s-hfarooq/IV18-Clock/pcb/v1/BOM_IV18-Clock_2023-02-18.csv

ID | Name | Designator | Footprint | Quantity | Manufacturer Part | Manufacturer | Supplier | Supplier Part | Price | Pins
1 | 19-213/Y2C-CQ2R2L/3T(CY) | 3V3,RXD1,TXD1 | LED0603-R-RD | 3 | 19-213/Y2C-CQ2R2L/3T(CY) | EVERLIGHT | LCSC | C72038 | 0.004 | 2
2 | 100uF | C1,C5,C6 | CAP-SMD_BD6.3-L6.6-W6.6-FD | 3 | EEEHA1C101WP | PANASONIC | LCSC | C128466 | 0.02 | 2
3 | 100nF | C2 | C0805 | 1 | 0805B104K500NT | FH(风华) | LCSC | C38141 | 0.001 | 2
4 | 10uF | C3,C4 | C0805 | 2 | CL21A106KPFNNNE | SAMSUNG(三星) | LCSC | C17024 | 0.002 | 2
5 | 300pF | C7 | C0805 | 1 | TCC0805COG301J500BT | CCTC(三环) | LCSC | C282698 | 0.001 | 2
6 | 100uH | L1 | L0805 | 1 | MLZ2012N101LT000 | TDK | LCSC | C88184 | 0.011 | 2
7 | Header-Female-2.54_2x10 | P1 | HDR-TH_20P-P2.54-V-F-R2-C10-S2.54 | 1 | 2.54-2*10P母 | BOOMELE(博穆精密) | LCSC | C30867 | 0.027 | 20
8 | Header-Male-2.54_2x4 | P2 | HDR-TH_8P-P2.54-V-M-R2-C4-S2.54 | 1 | Header2X4P 2.54mm | ReliaPro | LCSC | C58363 |  | 8
9 | 12kΩ | R1 | R0805 | 1 | 0805W8F1202T5E | UNI-ROYAL(厚声) | LCSC | C17444 |  | 2
10 | 330 | R2,R3,R4,R5,R7 | R0805 | 5 | ERJP06F3300V | PANASONIC | LCSC | C441977 | 0.007 | 2
11 | 560 | R6 | R0805 | 1 | ERJP06F5600V | PANASONIC | LCSC | C441979 | 0.006 | 2
12 | 5kΩ | R8 | R0805 | 1 | RTT055001FTP | RALEC(旺诠) | LCSC | C332873 |  | 2
13 | 30kΩ | R9 | R0805 | 1 | 0805W8F3002T5E | UNI-ROYAL(厚声) | LCSC | C17621 |  | 2
14 | 1.2kΩ | R10 | R0805 | 1 | RTT05122JTP | RALEC(旺诠) | LCSC | C103956 |  | 2
15 | 1Ω | R11,R12,R13 | R0805 | 3 | 0805W8F100KT5E | UNI-ROYAL(厚声) | LCSC | C25271 |  | 2
16 | 5.1kΩ | R14,R15 | R0805 | 2 | 0805W8F5101T5E | UNI-ROYAL(厚声) | LCSC | C27834 |  | 2
17 | Button-6x6x6mm | SW1 | SW-TH_4P-L6.0-W6.0-P4.50-LS6.1 | 1 | Switch,6*6*6Plastic head,260G, 0.25mm,Straight line | BBJ | LCSC | C71836 | 0.003 | 4
18 | ESP32-WROOM-32E(4MB) | U1 | WIFI-SMD_ESP32-WROOM-32E | 1 | ESP32-WROOM-32E-N4 | ESPRESSIF(乐鑫) | LCSC | C701341 | 0.56 | 39
19 | MAX6921AWI+T | U2 | SOIC-28_L17.9-W7.5-P1.27-LS10.3-BL | 1 | MAX6921AWI+T | MAXIM(美信) | LCSC | C3220330 | 1.036 | 28
20 | DHT11 | U3 | SENSOR-TH_DHT11 | 1 | DHT11 | 广州奥松 | LCSC | C117051 | 0.181 | 4
21 | LM317AG-TN3-R | U4 | TO-252-2_L6.5-W6.1-P4.58-LS10.0-TL | 1 | LM317AG-TN3-R | UTC | LCSC | C75510 | 0.034 | 3
22 | TL497ACDR | U5 | SOIC-14_L8.6-W3.9-P1.27-LS6.0-BL | 1 | TL497ACDR | TI(德州仪器) | LCSC | C2071303 | 0.267 | 14
23 | 213716-0001 | USB1 | USB-C-TH_TYPEC-306DDW-ARP16 | 1 | 213716-0001 | null | LCSC | C5119949 |  | 20
