s-hfarooq/IV18-Clock/pcb/v1/Schematic_IV18-Clock_2023-02-18.pdf

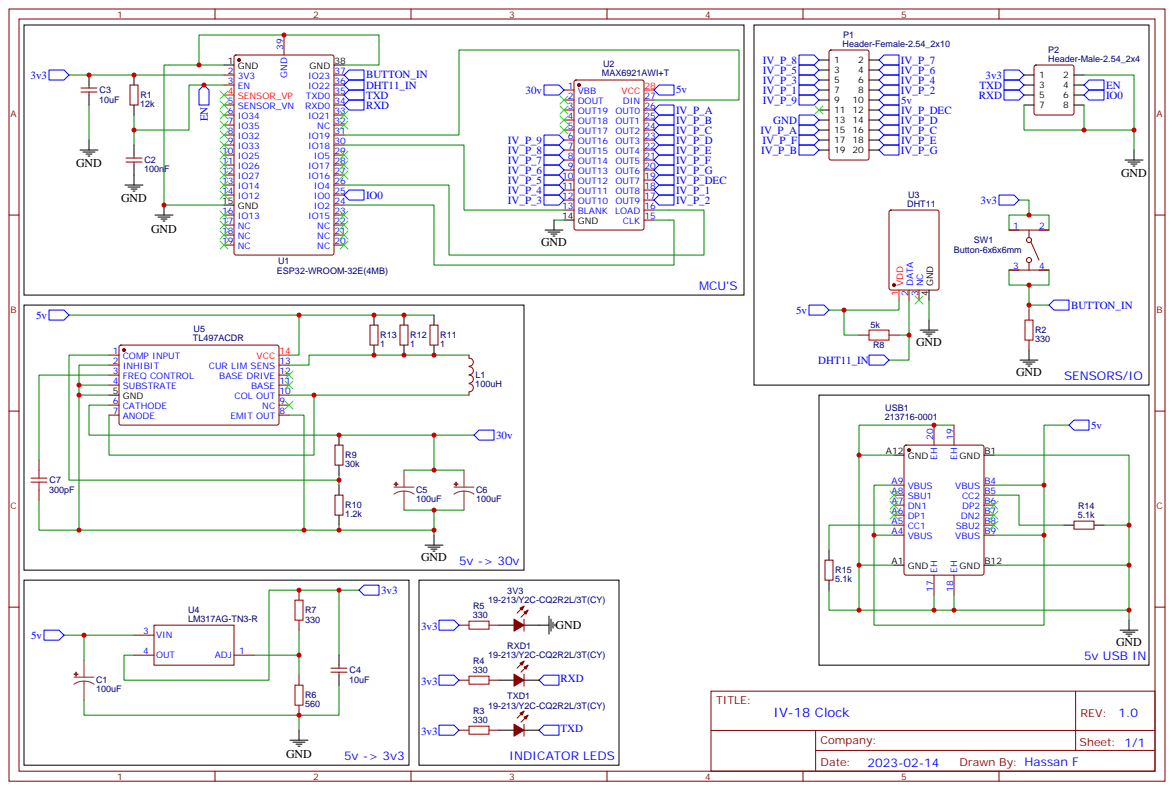
[picture p1: page 1]

TL497ACDR
COL OUT 10 BASE 11 BASE DRIVE 12 CUR LIM SENS 13 VCC 14
