s-hfarooq/IV18-Clock/pcb/v1/PCB_PCB_IV18-Clock_2023-02-18.pdf

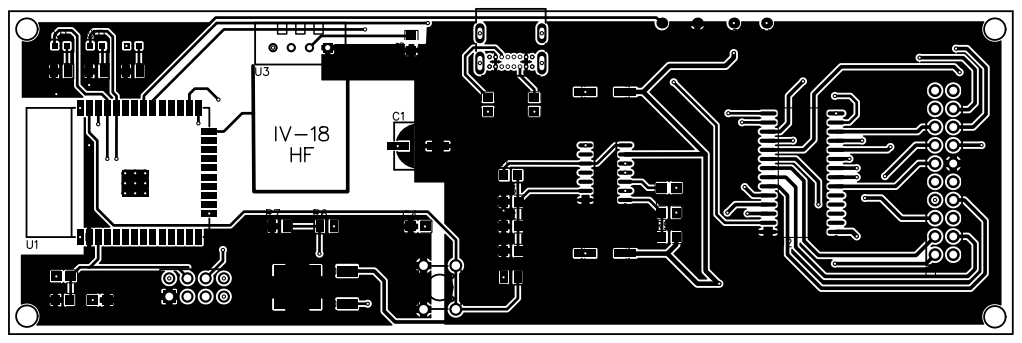
[picture p2: page 1]
