s-hfarooq/IV18-Clock/src/esp-clock/main/dht11.c

/*
 * MIT License
 * 
 * Copyright (c) 2018 Michele Biondi
 * 
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
 * THE SOFTWARE IS PROVIDED "AS IS", WITHOUT WARRANTY OF ANY KIND, EXPRESS OR
 * IMPLIED, INCLUDING BUT NOT LIMITED TO THE WARRANTIES OF MERCHANTABILITY,
 * FITNESS FOR A PARTICULAR PURPOSE AND NONINFRINGEMENT. IN NO EVENT SHALL THE
 * AUTHORS OR COPYRIGHT HOLDERS BE LIABLE FOR ANY CLAIM, DAMAGES OR OTHER
 * LIABILITY, WHETHER IN AN ACTION OF CONTRACT, TORT OR OTHERWISE, ARISING FROM,
 * OUT OF OR IN CONNECTION WITH THE SOFTWARE OR THE USE OR OTHER DEALINGS IN THE
 * SOFTWARE.
*/

#include "esp_timer.h"
#include "driver/gpio.h"
#include "rom/ets_sys.h"
#include "freertos/FreeRTOS.h"
#include "freertos/task.h"

#include "dht11.h"

static gpio_num_t dht_gpio;
static int64_t last_read_time = -2000000;
static struct dht11_reading last_read;

static unsigned int dht11_should_read;
static unsigned int should_produce_error;

static int _waitOrTimeout(uint16_t microSeconds, int level) {
    int micros_ticks = 0;
    while(gpio_get_level(dht_gpio) == level) { 
        if(micros_ticks++ > microSeconds) 
            return DHT11_TIMEOUT_ERROR;
        ets_delay_us(1);
    }
    return micros_ticks;
}

static int _checkCRC(uint8_t data[]) {
    if(data[4] == (data[0] + data[1] + data[2] + data[3]))
        return DHT11_OK;
    else
        return DHT11_CRC_ERROR;
}

static void _sendStartSignal() {
    gpio_set_direction(dht_gpio, GPIO_MODE_OUTPUT);
    gpio_set_level(dht_gpio, 0);
    ets_delay_us(20 * 1000);
    gpio_set_level(dht_gpio, 1);
    ets_delay_us(40);
    gpio_set_direction(dht_gpio, GPIO_MODE_INPUT);
}

static int _checkResponse() {
    /* Wait for next step ~80us*/
    if(_waitOrTimeout(80, 0) == DHT11_TIMEOUT_ERROR)
        return DHT11_TIMEOUT_ERROR;

    /* Wait for next step ~80us*/
    if(_waitOrTimeout(80, 1) == DHT11_TIMEOUT_ERROR) 
        return DHT11_TIMEOUT_ERROR;

    return DHT11_OK;
}

static struct dht11_reading _timeoutError() {
    struct dht11_reading timeoutError = {DHT11_TIMEOUT_ERROR, -1, -1};
    return timeoutError;
}

static struct dht11_reading _crcError() {
    struct dht11_reading crcError = {DHT11_CRC_ERROR, -1, -1};
    return crcError;
}

void dht11_preform_read() {
    while(1) {
        if(dht11_should_read) {
            last_read_time = esp_timer_get_time();

            uint8_t data[5] = {0,0,0,0,0};

            _sendStartSignal();

            if(_checkResponse() == DHT11_TIMEOUT_ERROR) {
                if(should_produce_error)
                    last_read = _timeoutError();
                goto endOfLoop;
            }
            
            /* Read response */
            for(int i = 0; i < 40; i++) {
                /* Initial data */
                if(_waitOrTimeout(50, 0) == DHT11_TIMEOUT_ERROR) {
                    if(should_produce_error)
                        last_read = _timeoutError();
                    goto endOfLoop;
                }
                        
                if(_waitOrTimeout(70, 1) > 28) {
                    /* Bit received was a 1 */
                    data[i/8] |= (1 << (7-(i%8)));
                }
            }

            if(_checkCRC(data) != DHT11_CRC_ERROR) {
                last_read.status = DHT11_OK;
                last_read.temperature = data[2];
                last_read.humidity = data[0];
                goto endOfLoop;
            } else {
                if(should_produce_error)
                    last_read = _crcError();
                goto endOfLoop;
            }
        }

        endOfLoop:
        dht11_should_read = 0;

        vTaskDelay(100 / portTICK_PERIOD_MS);
    }

    vTaskDelete(NULL);
}

void DHT11_init(gpio_num_t gpio_num) {
    /* Wait 1 seconds to make the device pass its initial unstable status */
    vTaskDelay(1000 / portTICK_PERIOD_MS);
    dht_gpio = gpio_num;
    dht11_should_read = 1;
    should_produce_error = 0;

    last_read.status = DHT11_TIMEOUT_ERROR;
    last_read.temperature = 0;
    last_read.humidity = 0;
}

struct dht11_reading DHT11_read() {
    /* Tried to sense too son since last read (dht11 needs ~2 seconds to make a new read) */
    if(esp_timer_get_time() - 2000000 >= last_read_time)
        dht11_should_read = 1;

    return last_read;
}
