s-hfarooq/IV18-Clock/(commit log)

2023-02-04 Set tube function
2023-02-04 2 cores - 1 to dispatch, 1 for tube display
2023-02-05 Physical button to change state
2023-02-05 Getting temp from sensor
2023-02-18 Fixed temp flashing issue
    [dht11.c, dht11.h]
2023-02-18 Adding PCB
    [BOM_IV18-Clock_2023-02-18.csv]
